lingex/RemoteBox/doc/PixPin_2026-07-06_21-58-16.png

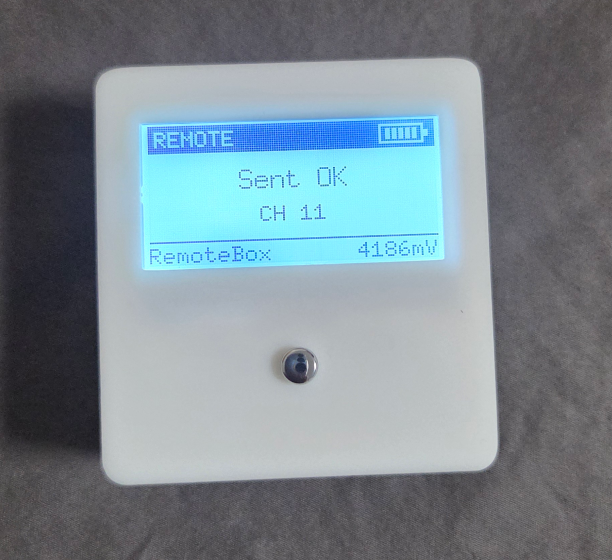
doc/PixPin_2026-07-06_21-58-16.png
