lingex/RemoteBox/doc/PixPin_2026-07-06_00-37-21.png

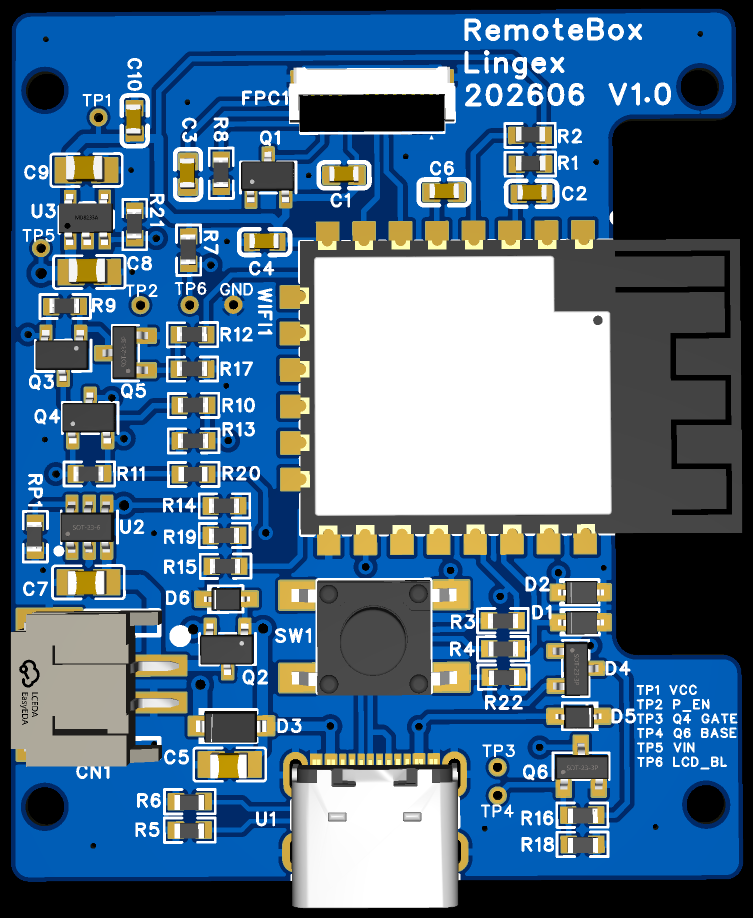
doc/PixPin_2026-07-06_00-37-21.png
