lingex/RemoteBox/doc/SCH_Schematic1_1-P1_2026-06-14.png

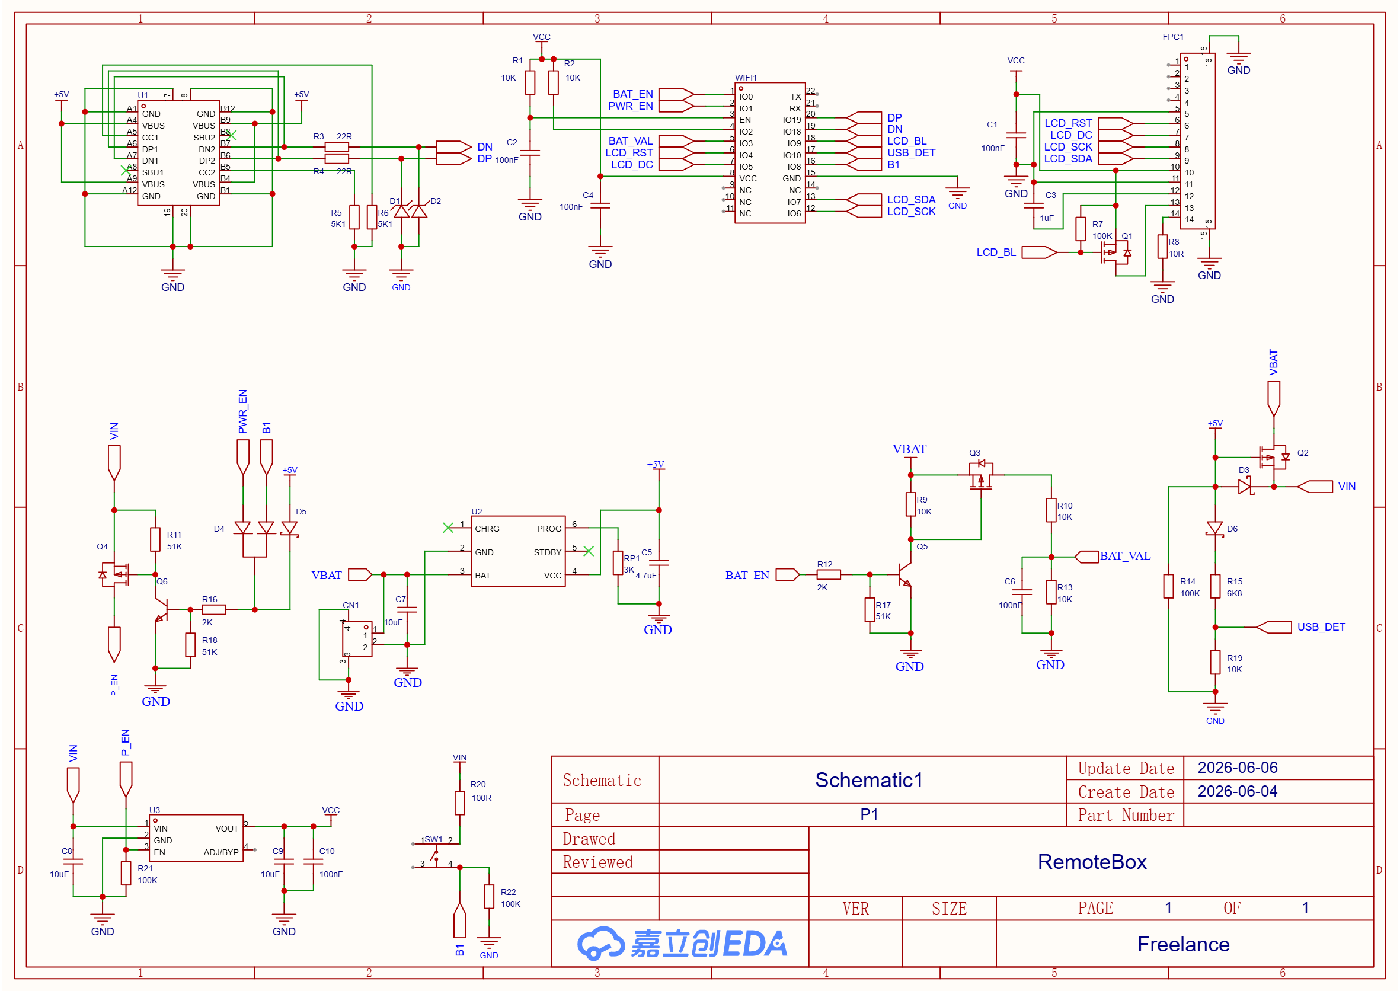
doc/SCH_Schematic1_1-P1_2026-06-14.png
