lingex/RemoteBox/doc/SCH_Schematic1_2026-06-09.pdf

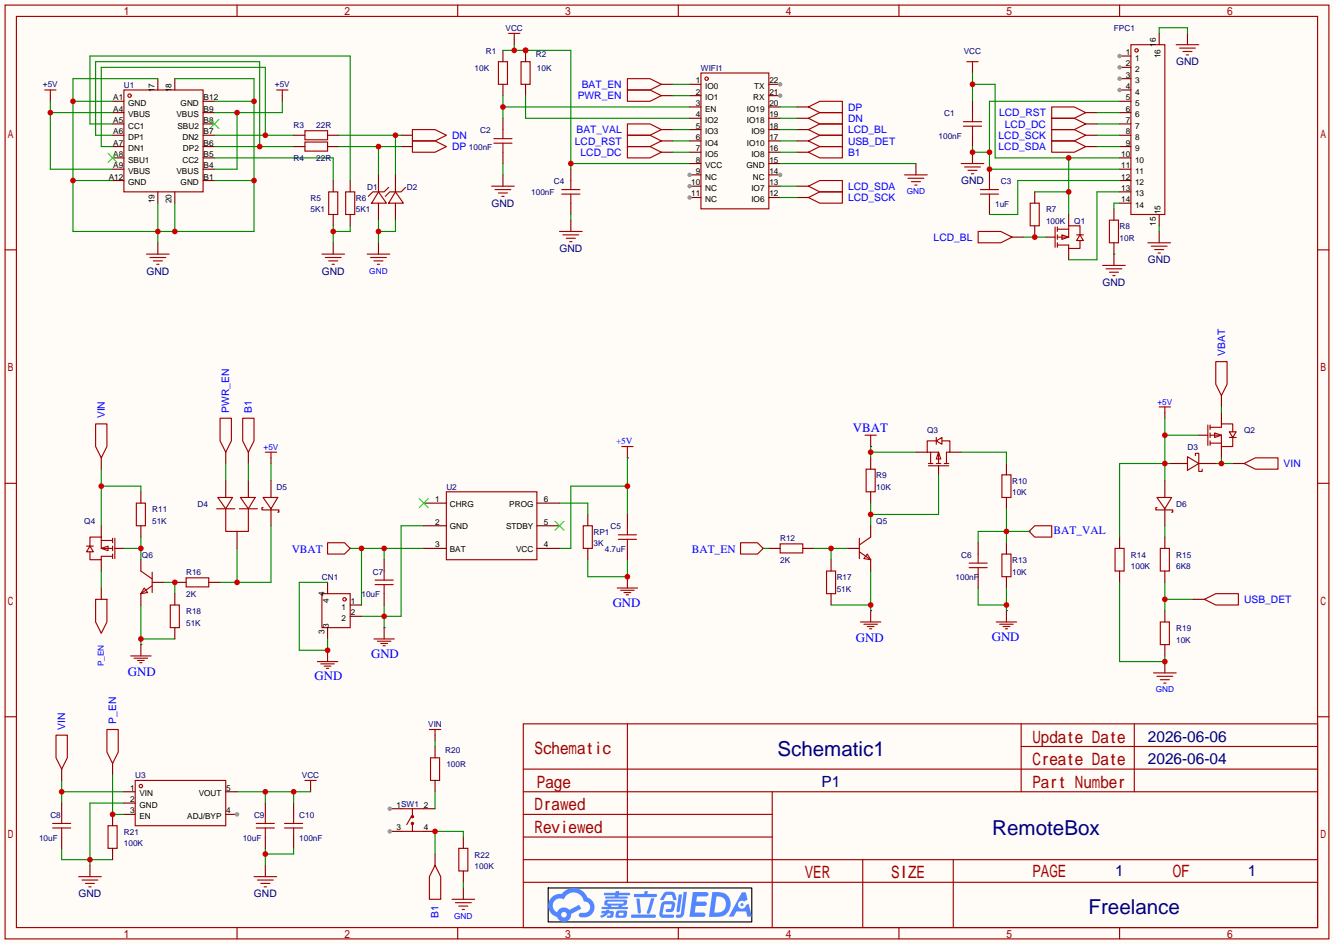
[picture p4: page 1]

GND B1 GND A12 VBUS A9 SBU1 A8 DN1 A7 DP1 A6 CC1 A5 VBUS A4 GND A1
