lingex/RemoteBox/doc/PCB_PCB1_2026-06-09.pdf

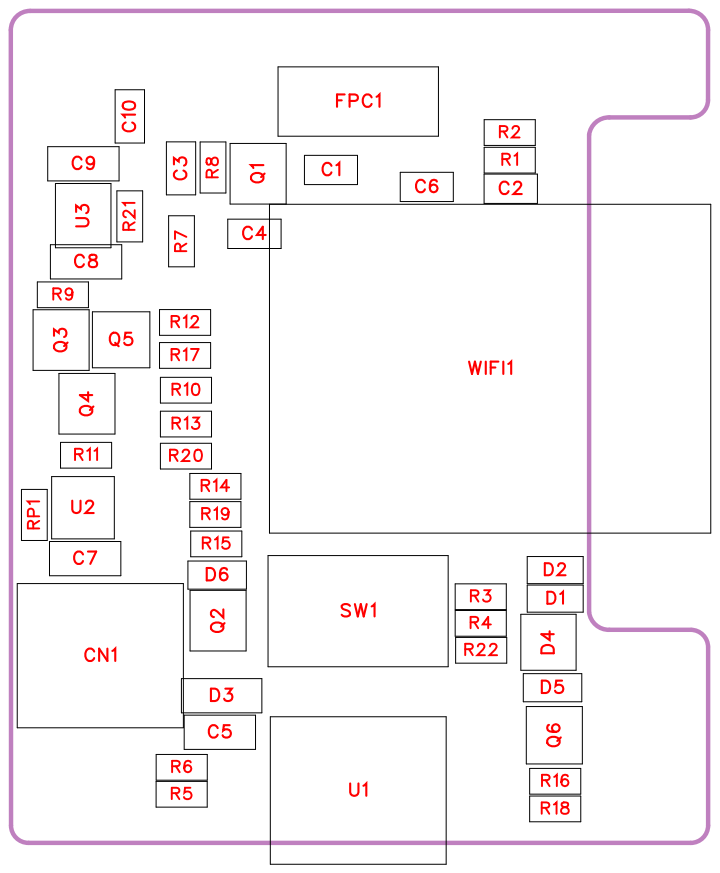
[picture p5: page 1]

D3 | | D5
C5 | U1

No. | Quantity | Device | Designator | Footprint | Value
1 | 5 | CAP_0603 | C1,C2,C4,C6,C10 | C0603 | 100nF
2 | 1 | CAP_0603 | C3 | C0603 | 1uF
3 | 1 | CAP_0805 | C5 | C0805 | 4.7uF
4 | 3 | CAP_0805 | C7,C8,C9 | C0805 | 10uF
5 | 1 | PH2.0mm-2P -WT | CN1 | CONN-SMD_ 2P-P2.00_P H2.0-2PWT
6 | 2 | CESD3V3D3 | D1,D2 | SOD-323_L1 .7-W1.3-LS2. 5-RD
7 | 1 | B5819W SL | D3 | SOD-123_L2 .7-W1.6-LS3. 7-RD-1
8 | 1 | BAT54C | D4 | SOT-23-3_L2 .9-W1.3-P1.9 0-LS2.4-BR
9 | 2 | BAT60A | D5,D6 | SOD-323_L1 .8-W1.3-LS2. 5-RD
10 | 1 | HC-FPC-05-09-14RLTAG | FPC1 | FPC-SMD_1 4P-P0.50_H C-FPC-05-09 -14RLTAG
11 | 4 | SI2301CDS-T1-GE3 | Q1,Q2,Q3,Q4 | SOT-23-3_L3 .0-W1.7-P0.9 5-LS2.9-BR
12 | 2 | MMBT3904( RANGE:100-300) | Q5,Q6 | SOT-23-3_L2 .9-W1.3-P1.9 0-LS2.4-BR
13 | 6 | Res_0603 | R1,R2,R9,R10,R13,R19 | R0603 | 10K
14 | 2 | Res_0603 | R3,R4 | R0603 | 22R
15 | 2 | Res_0603 | R5,R6 | R0603 | 5K1
16 | 4 | Res_0603 | R7,R14,R21,R22 | R0603 | 100K
17 | 1 | Res_0603 | R8 | R0603 | 10R
18 | 3 | Res_0603 | R11,R17,R18 | R0603 | 51K
19 | 2 | Res_0603 | R12,R16 | R0603 | 2K
20 | 1 | Res_0603 | R15 | R0603 | 6K8
21 | 1 | Res_0603 | R20 | R0603 | 100R
22 | 1 | Res_0603 | RP1 | R0603 | 3K
23 | 1 | TSX06311-0 90D332DH-R 0500 | SW1 | SW-SMD_4P -L6.1-W6.1-P 4.50-LS8.7-T L
24 | 1 | TYPE-C-12P | U1 | USB-SMD_T YPE-C16PIN

25 | 1 | TP4057_C20 199358 | U2 | SOT-23-6_L2 .9-W1.6-P0.9 5-LS2.8-BL
26 | 1 | SPX3819M5-3.3 | U3 | SOT-23-5_L2 .9-W1.6-P0.9 5-LS2.8-BL
27 | 1 | ESP32-C3-1 2F | WIFI1 | WIRELM-SM D_ESP-C3-1 2F-4M

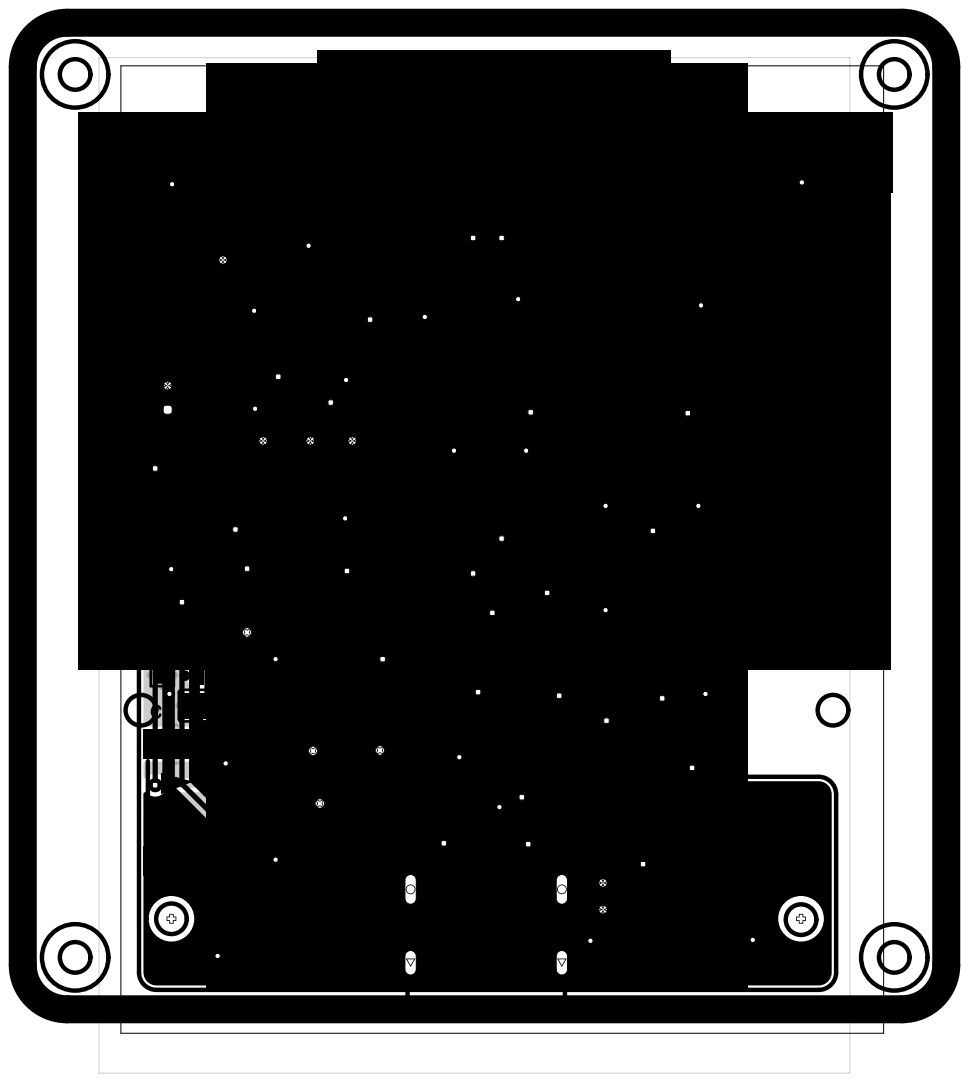
[picture p6: page 5]

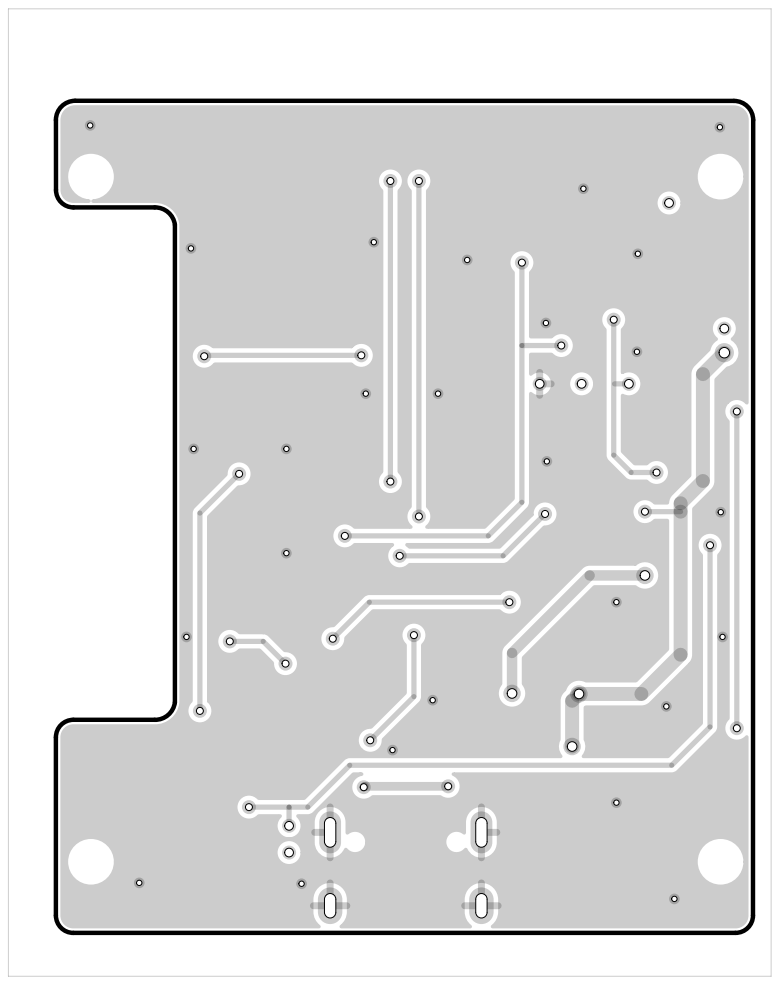
[picture p7: page 6]

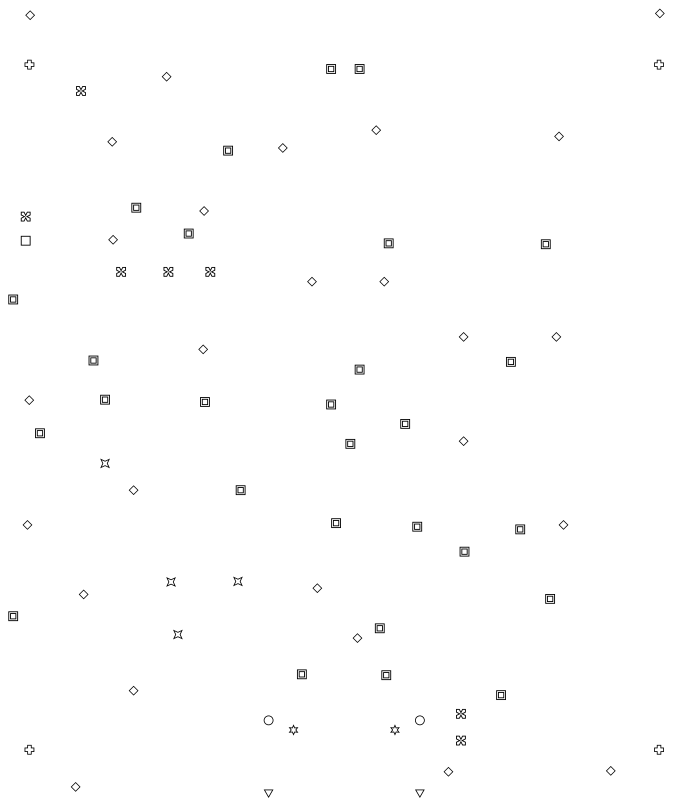
[picture p8: page 7]
