lingex/RemoteBox/(commit log)

2026-07-06 basic function
    [BOM_Board1_PCB1_2026-06-09.xlsx, partitions.csv]
2026-08-13 feat: add USB-only web management and OTA
    Start Wi-Fi, web, mDNS, and ESPOTA services only in USB mode with complete credentials. Add validated config editing, synchronize the ESP-NOW channel with Wi-Fi, update the USB standby screen, and introduce OTA-capable partitions.
    [partitions.csv]
2026-09-14 Shorten ESP-NOW command UID to eight bytes
    [main.cpp]
